Enigma-124/3D-Printable-Laptop-Cooling-Pad/production/3D-Print/Laptop Cooling Pad.step

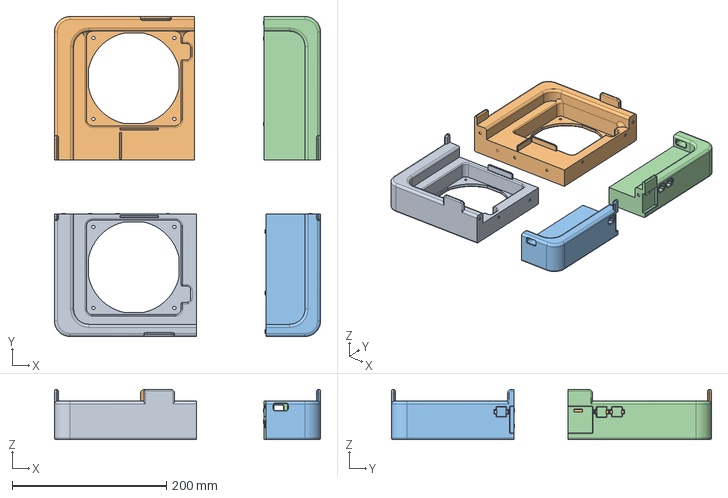
[picture p11: CAD file, 2026-10-29]
production/3D-Print/Laptop Cooling Pad.step
345.0 x 415.0 x 65.0 mm
