Enigma-124/3D-Printable-Laptop-Cooling-Pad/src/Body/Body.step

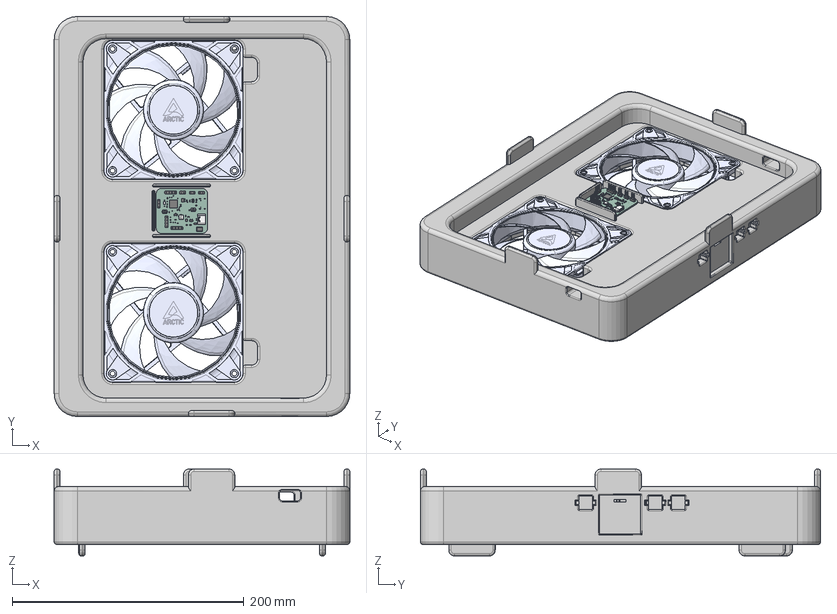
[picture p12: CAD file, 2026-09-25]
src/Body/Body.step
255.0 x 345.0 x 75.0 mm
