Enigma-124/3D-Printable-Laptop-Cooling-Pad/src/PCB/PCB.step

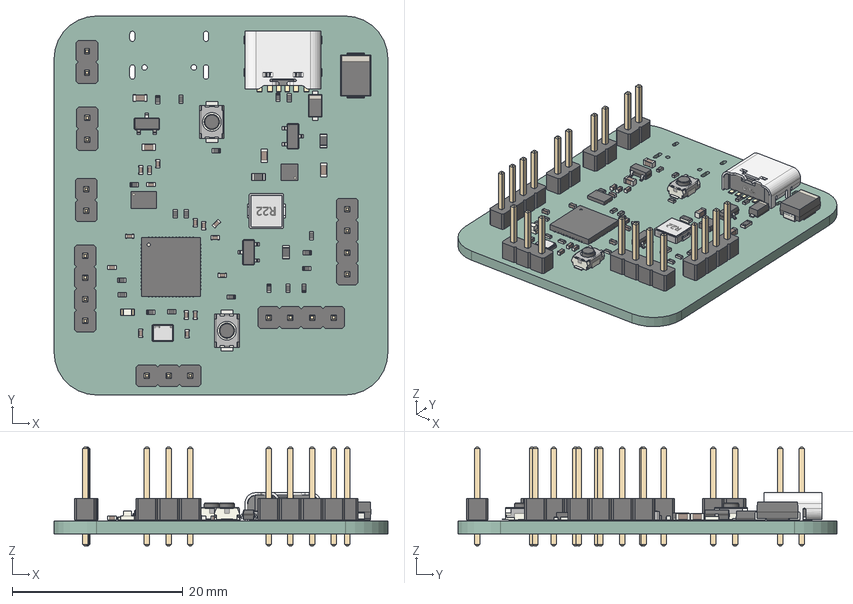
[picture p13: CAD file, 2026-09-25]
src/PCB/PCB.step
39.1 x 44.4 x 11.5 mm
C_0402_1005Metric x 15
D_SMB
R_0402_1005Metric x 19
PinHeader_1x02_P254mm_Vertical x 3
SW_Push_SPST_NO_Alps_SKRK x 2
PinHeader_1x03_P254mm_Vertical
PinHeader_1x04_P254mm_Vertical x 3
USB-C-SMD_TYPE-C-6P-WTL6.8-108
R_0603_1608Metric x 3
C_0603_1608Metric x 4
LED_0603_1608Metric
WSON_8_1EP_2x2mm_P05mm_EP09x16mm
SOT-23 x 3
Winbond_USON-8-1EP_3x2mm_P0.5mm_EP0.2x1.6mm
D_SOD_123F
CRYSTAL-SMD_4P-L2.5-W2.0-BL-1
IND-SMD_L4.5-W4.1-H1.2_SRP4020TA
QFN-56-1EP_7x7mm_P0.4mm_EP3.2x3.2mm
PCB_PCB
