Enigma-124/3D-Printable-Laptop-Cooling-Pad/production/3D-Print/Cooling_Pad_Part_2.stl

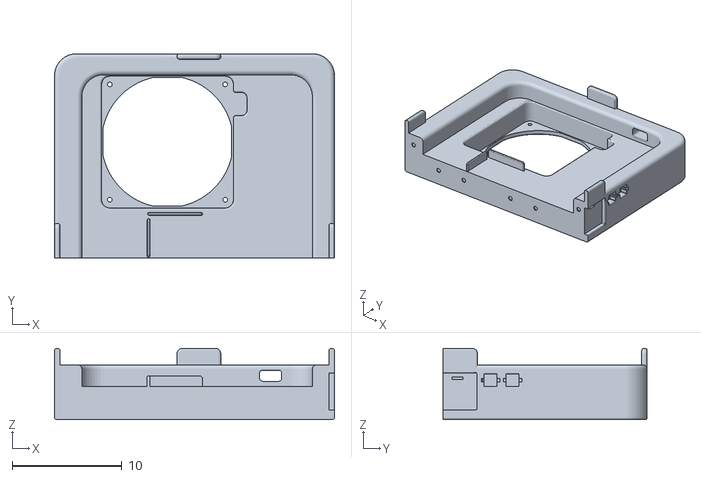
[picture p14: CAD file, 2026-10-03]
production/3D-Print/Cooling_Pad_Part_2.stl
25.5 x 18.6 x 6.50
