Enigma-124/3D-Printable-Laptop-Cooling-Pad/production/3D-Print/Cooling_Pad_Part_1.stl

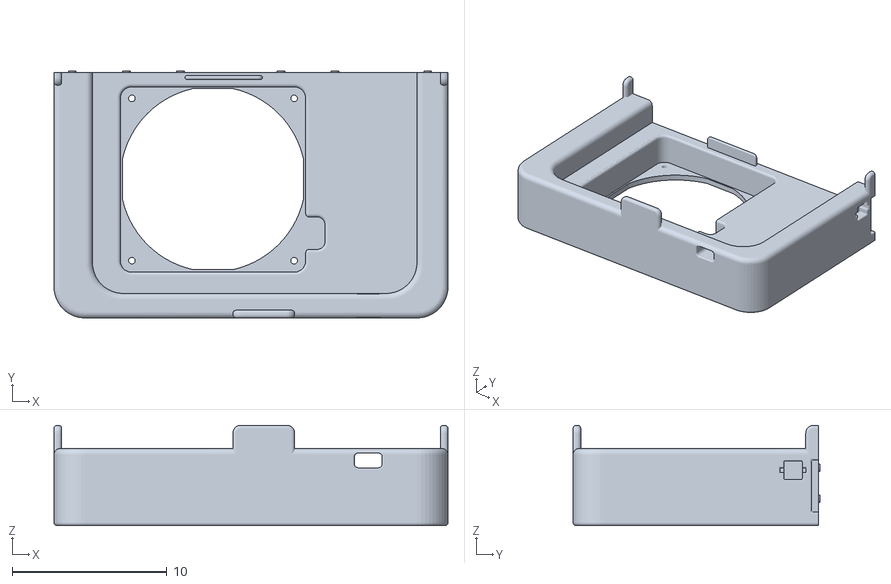
[picture p15: CAD file, 2026-10-03]
production/3D-Print/Cooling_Pad_Part_1.stl
25.5 x 16.0 x 6.50
