Enigma-124/3D-Printable-Laptop-Cooling-Pad/(list of files, cad)

Other CAD files:
src/Body/Laptop Cooling Pad.f3d
